cedricvidal/max-pump-3-lost-horizon-mattress-adaptor/final/final-2.jpeg

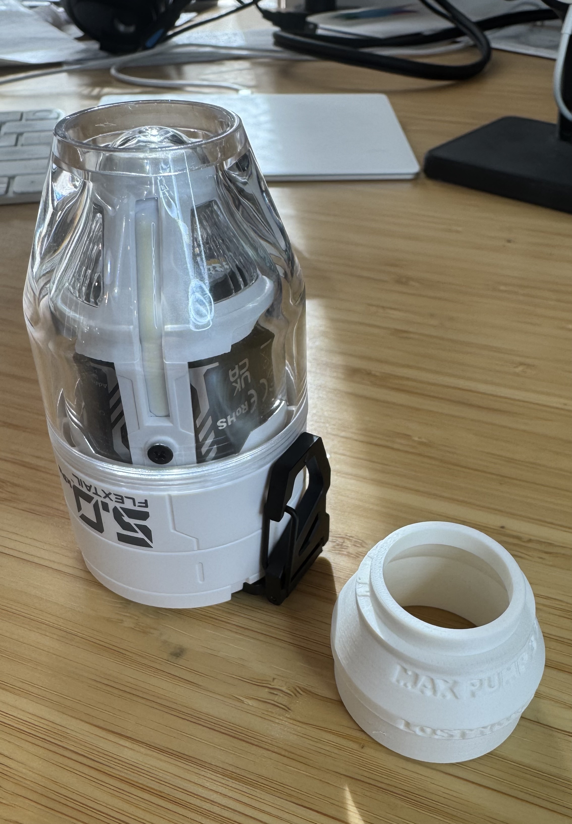
final/final-2.jpeg
