cedricvidal/max-pump-3-lost-horizon-mattress-adaptor/pictures/max-pump-3-base.jpeg

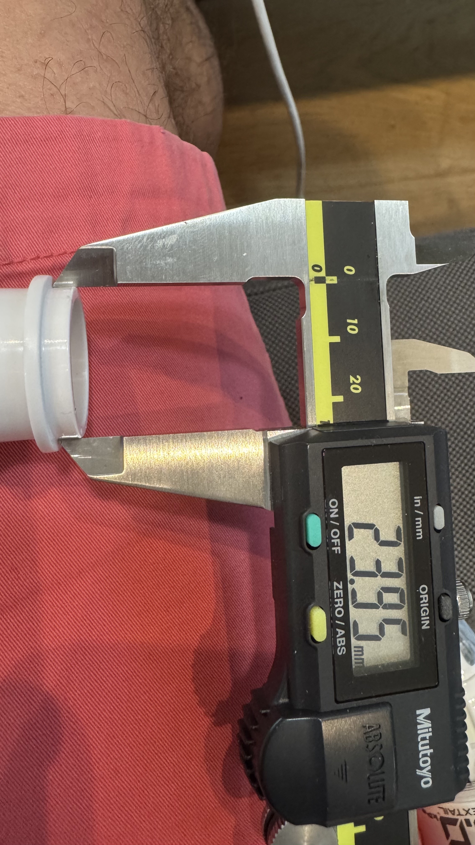
pictures/max-pump-3-base.jpeg
