cedricvidal/max-pump-3-lost-horizon-mattress-adaptor/pictures/original-mat-dimension-1.jpeg

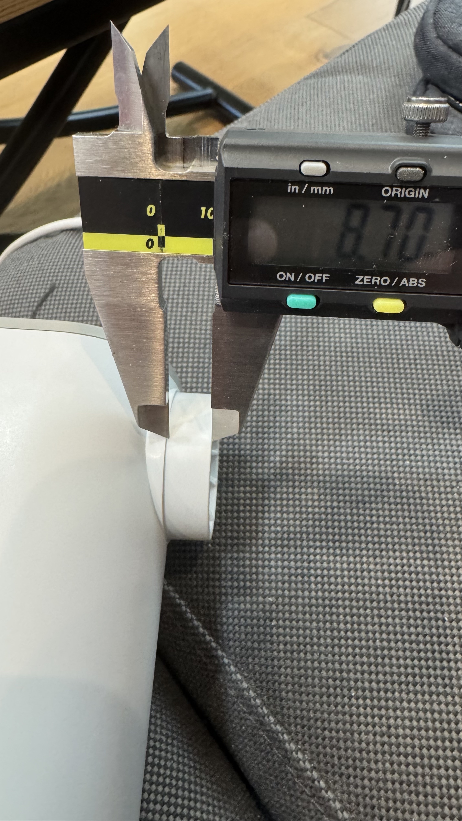
pictures/original-mat-dimension-1.jpeg
