cedricvidal/max-pump-3-lost-horizon-mattress-adaptor/pictures/original-pump.jpeg

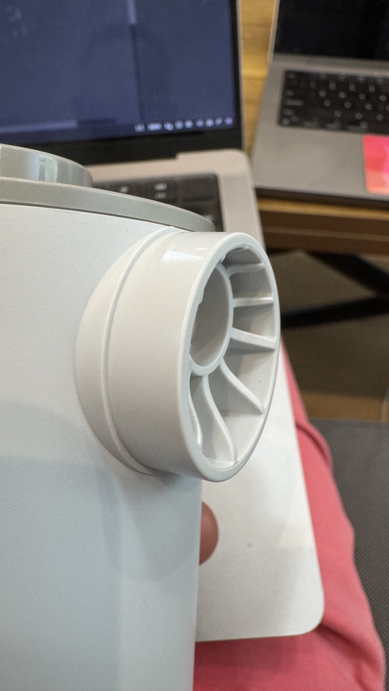
pictures/original-pump.jpeg
