cedricvidal/max-pump-3-lost-horizon-mattress-adaptor/max-pump-3_lost-horizon_adaptor.3mf

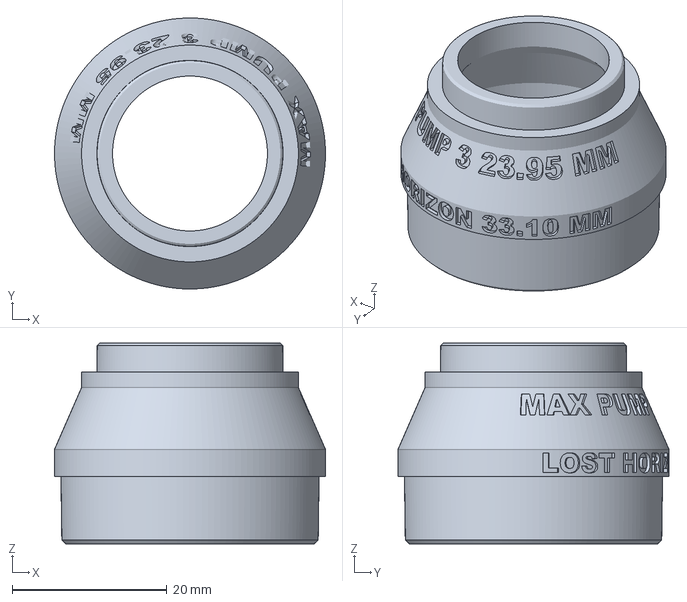
[picture p12: CAD file, 2026-10-16]
max-pump-3_lost-horizon_adaptor.3mf
35.0 x 35.0 x 25.9 mm
