cedricvidal/max-pump-3-lost-horizon-mattress-adaptor/out/fit-test/fit-test_nozzle_+0.10.stl

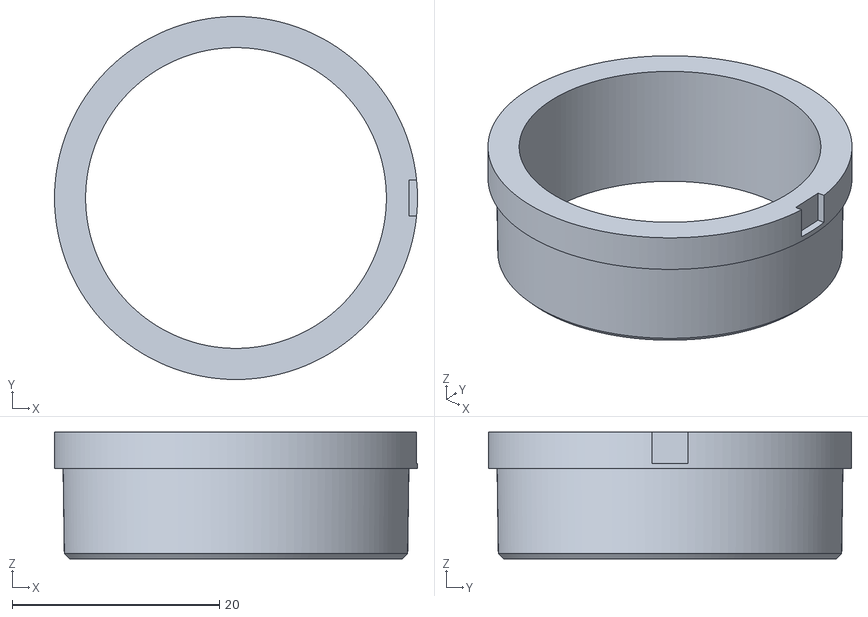
[picture p13: CAD file, 2026-10-16]
out/fit-test/fit-test_nozzle_+0.10.stl
35.0 x 35.0 x 12.2
