cedricvidal/max-pump-3-lost-horizon-mattress-adaptor/out/fit-test/fit-test_plug_+0.20.stl

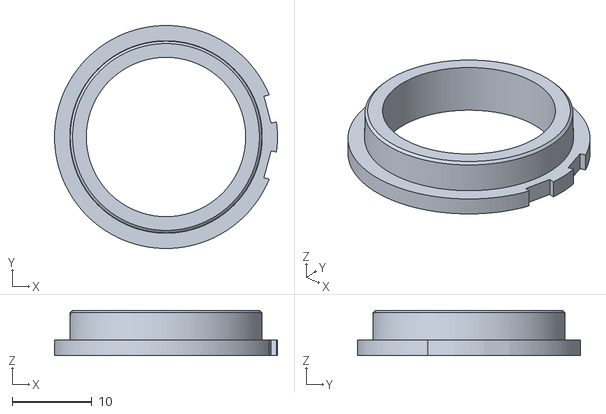
[picture p14: CAD file, 2026-10-16]
out/fit-test/fit-test_plug_+0.20.stl
28.0 x 28.0 x 5.70
