cedricvidal/max-pump-3-lost-horizon-mattress-adaptor/(list of files, cad)

Other CAD files:
out/max-pump-3_lost-horizon_adaptor.stl
out/fit-test/fit-test_nozzle_+0.20.stl
out/fit-test/fit-test_plug_+0.10.stl
out/fit-test/fit-test_nozzle_+0.00.stl
out/fit-test/fit-test_plug_+0.00.stl
max-pump-3-lost-horizon-adaptor.blend
out/fit-test/fit-test_nozzle_-0.10.stl
out/fit-test/fit-test_nozzle_-0.20.stl
out/fit-test/fit-test_plug_-0.10.stl
out/fit-test/fit-test_plug_-0.20.stl
