cedricvidal/max-pump-3-lost-horizon-mattress-adaptor/(commit log)

2026-10-15 chore: add source IKEA vacuum bag adapter for Flextail Max Pump 3
    Original model from MakerWorld 2165161, used as the remix base.
    source/ holds the STL extracted from the zip, used as a Blender reference.
    [Ikea Vacuum Bag adapter for Flextail.stl, Ikea+Vacuum+Bag+adapter+for+Flextail.3mf]
2026-10-15 docs: add photos and caliper measurements of the original pump nozzle
    Nozzle sticks out 8.70 mm, OD 33.00 mm at tip, 33.25 mm at base.
2026-10-15 feat: add parametric Blender script for the Lost Horizon mattress adaptor
    Revolves a half-section profile: original 42/35.7 mm pump socket,
    transition cone, and a replica of the original pump nozzle
    (33.25 -> 33.00 mm OD taper, 8.7 mm long, 0.5 mm tip chamfer).
    Imports the original STL as a hidden reference, checks the mesh, and
    exports STL + .blend.
2026-10-15 build: add generated adaptor STL and Blender file
    [max-pump-3-lost-horizon-adaptor.blend, max-pump-3_lost-horizon_adaptor.stl]
2026-10-15 fix: exclude hidden reference model from STL export
    The reference lives in a hidden collection, so select_all() could not
    deselect it after import and it was exported with the adaptor (4446
    triangles, 54 mm tall). Deselect it right after import; the STL now
    contains only the adaptor (2304 triangles, 28.7 mm).
    [max-pump-3_lost-horizon_adaptor.stl]
2026-10-15 chore: stop redistributing the original IKEA adapter model
    Remove the MakerWorld zip, 3mf and extracted STL; link the model in the
    script instead. The reference overlay is now optional: download the STL
    into source/ (gitignored) to enable it. The .blend is regenerated
    without it.
    [Ikea Vacuum Bag adapter for Flextail.stl, Ikea+Vacuum+Bag+adapter+for+Flextail.3mf, max-pump-3-lost-horizon-adaptor.blend]
2026-10-16 docs: move photos to pictures/ and add Max Pump 3 plug measurements
    Flextail nozzle plug: 23.96 mm OD at the collar, 23.85 mm at the tip,
    sticking out 3.70 mm past the collar.
2026-10-16 fix: plug into the pump port instead of keeping the IKEA valve socket
    The pump has a female port: the IKEA adapter's small end (28 mm collar +
    23.8 mm plug) goes into it and its 42 mm socket goes over the IKEA valve.
    The previous design kept the wrong end.
    New profile, printed mattress tip down:
    - mattress nozzle 33.00 -> 33.25 mm OD, 8.7 mm, 0.5 mm chamfer
    - 38 mm shoulder flange with a 45 deg flared underside
    - cone to a 28 mm collar
    - pump plug 23.96 -> 23.85 mm OD, 3.7 mm, 20 mm bore
    [max-pump-3-lost-horizon-adaptor.blend, max-pump-3_lost-horizon_adaptor.stl]
2026-10-16 feat: replace flared 38 mm flange with a thin straight stop ring
    Match the original pump's stop behind the mattress nozzle: a square
    step to 35 mm OD, 3.5 mm deep (estimated from the photos), instead of
    a 45 deg flare to a 38 mm flange. Part is now 35 x 35 x 25.9 mm.
    [max-pump-3-lost-horizon-adaptor.blend, max-pump-3_lost-horizon_adaptor.stl]
2026-10-16 feat: add -0.1 mm press-fit offset and fit-test rings
    FIT_OFFSET shrinks the nozzle and plug diameters to allow for FDM parts
    printing slightly oversize; measured values stay unchanged in the script.
    Nozzle 32.90 -> 33.15 mm, plug 23.86 -> 23.75 mm.
    Export short test rings (nozzle + stop ring, collar + plug) at 0, -0.1
    and -0.2 mm to out/fit-test/ to pick the offset with a quick print.
    [fit-test_nozzle_+0.00.stl, fit-test_nozzle_-0.10.stl, fit-test_nozzle_-0.20.stl, fit-test_plug_+0.00.stl, fit-test_plug_-0.10.stl, fit-test_plug_-0.20.stl, max-pump-3-lost-horizon-adaptor.blend, max-pump-3_lost-horizon_adaptor.stl]
2026-10-16 feat: thin the middle walls with a bore that follows the outer cone
    The bore narrowed from 29 to 20 mm along its own straight line, leaving
    4-4.6 mm walls through the stop ring, cone and collar. It now keeps a
    constant 2 mm wall (CONE_WALL) parallel to the outer cone, then a 42 deg
    chamfer to the 20 mm plug bore, computed from the outer settings.
    Solid volume 7.2 -> 5.4 cm3 (-25%). Outer dimensions and fits unchanged;
    the stop ring keeps a 3 mm wall.
    [max-pump-3-lost-horizon-adaptor.blend, max-pump-3_lost-horizon_adaptor.stl]
2026-10-16 feat: mark fit-test rings with one notch per 0.1 mm of offset
    Notches (1.5 mm wide, 0.8 mm deep) are cut into the top of the stop
    ring side on nozzle rings and into the collar edge on plug rings, away
    from the surfaces that seal against the valve or the pump. The 0.0 mm
    rings have none, -0.1 one, -0.2 two.
    [fit-test_nozzle_-0.10.stl, fit-test_nozzle_-0.20.stl, fit-test_plug_-0.10.stl, fit-test_plug_-0.20.stl, max-pump-3-lost-horizon-adaptor.blend]
2026-10-16 feat: per-end fit offsets and wider plug test rings
    Fit test on the pump: only the 0.0 plug ring fit, and loosely. Split
    FIT_OFFSET into NOZZLE_FIT_OFFSET (-0.1, untested) and PLUG_FIT_OFFSET
    (0.0, best so far), so the adaptor plug is back to the measured
    23.96 -> 23.85 mm.
    Add plug test rings at +0.1 and +0.2 mm, marked with wide notches
    (3.5 mm, 30 deg apart) so they can't be confused with the narrow-notched
    smaller rings (1.5 mm, 15 deg).
    [fit-test_plug_+0.10.stl, fit-test_plug_+0.20.stl, max-pump-3-lost-horizon-adaptor.blend, max-pump-3_lost-horizon_adaptor.stl]
2026-10-16 feat: set plug fit offset to +0.1 mm from the pump fit test
    Of the plug test rings (0, -0.1, -0.2, +0.1, +0.2) the +0.1 one fit the
    Max Pump 3 best. Adaptor plug is now 24.06 -> 23.95 mm OD.
    [max-pump-3-lost-horizon-adaptor.blend, max-pump-3_lost-horizon_adaptor.stl]
2026-10-16 feat: engrave pump and mattress labels on the adaptor
    Wrap 0.5 mm deep Arial Black labels around the outside, generated from
    the tip diameters so they track the fit offsets:
    - cone below the collar, 2 lines: MAX PUMP 3 / 23.95 MM (2.8 mm caps)
    - stop ring side: LOST HORIZON 32.90 (2.6 mm caps)
    Font conversion leaves glyph solids unwelded and Arial Black glyphs
    overlap themselves, so weld them, check they are closed, and enable
    use_self on the exact boolean; assert the cut never empties the mesh.
    Shared boolean code moved into subtract(), also used by the notches.
    [max-pump-3-lost-horizon-adaptor.blend, max-pump-3_lost-horizon_adaptor.stl]
2026-10-16 feat: engrave the pump label on one line at the top of the cone
    MAX PUMP 3 23.95 MM on a single 2.8 mm line, 0.8 mm below the collar,
    wrapping 181 deg. Replace the half-way-round limit with a 300 deg one
    (MAX_LABEL_SPAN) so a label can wrap further but never meets itself.
    [max-pump-3-lost-horizon-adaptor.blend, max-pump-3_lost-horizon_adaptor.stl]
2026-10-16 feat: add MM to the mattress label
    LOST HORIZON 32.90 MM on the stop ring, matching the pump label;
    wraps 160 deg.
    [max-pump-3-lost-horizon-adaptor.blend, max-pump-3_lost-horizon_adaptor.stl]
2026-10-16 feat: add wider nozzle test rings at +0.1 and +0.2 mm
    The mattress valve test was snug; add nozzle rings at +0.1 (33.10 ->
    33.35 mm) and +0.2 (33.20 -> 33.45 mm), marked with wide notches like
    the wider plug rings.
    [fit-test_nozzle_+0.10.stl, fit-test_nozzle_+0.20.stl, max-pump-3-lost-horizon-adaptor.blend]
2026-10-16 fix: engrave every glyph; H, N and 1 were silently skipped
    recalc_face_normals turned some Arial Black glyph solids inside out
    (H, N, 1), so the boolean removed nothing for them: the committed
    mattress label read 'LOST ORIZO 32.90 MM'. Orient each glyph island
    by its signed volume instead; every character used now cuts its full
    depth.
    Also switch Blender to Object Mode before building, since selection and
    export operators fail in Edit Mode.
    [max-pump-3-lost-horizon-adaptor.blend, max-pump-3_lost-horizon_adaptor.stl]
2026-10-16 feat: set nozzle fit offset to +0.1 mm from the valve fit test
    Of the nozzle test rings (0, -0.1, -0.2, +0.1, +0.2) the +0.1 one fit
    the Lost Horizon valve best. Mattress nozzle is now 33.10 -> 33.35 mm;
    the label reads LOST HORIZON 33.10 MM.
    [max-pump-3-lost-horizon-adaptor.blend, max-pump-3_lost-horizon_adaptor.stl]
2026-10-16 feat: separate label names and diameters with a bullet
    MAX PUMP 3 • 23.95 MM and LOST HORIZON • 33.10 MM. The bullet is a
    ~0.9 mm round dot at these sizes, large enough to engrave cleanly
    (a middle dot or dash would be only 0.3-0.5 mm tall). Labels now wrap
    193 and 170 deg.
    [max-pump-3-lost-horizon-adaptor.blend, max-pump-3_lost-horizon_adaptor.stl]
2026-10-16 chore: add Bambu Studio project for the X1C print
    Adaptor STL from 89f97c4 rotated for printing, with the settings used
    for the fit tests and the final print: X1C 0.4 nozzle, 0.16mm High
    Quality, Bambu PLA Basic, outer-only brim, aligned seam.
    [max-pump-3_lost-horizon_adaptor.3mf]
2026-10-16 docs: add photos and video of the printed adaptor
2026-10-16 docs: add README with measurements, fit testing and print settings
